ramtop-retro/ostc/(list of files, drawings)

Other design files:
PCB/ostc44_07.dip
